rockers13/GTA/UML Class.png

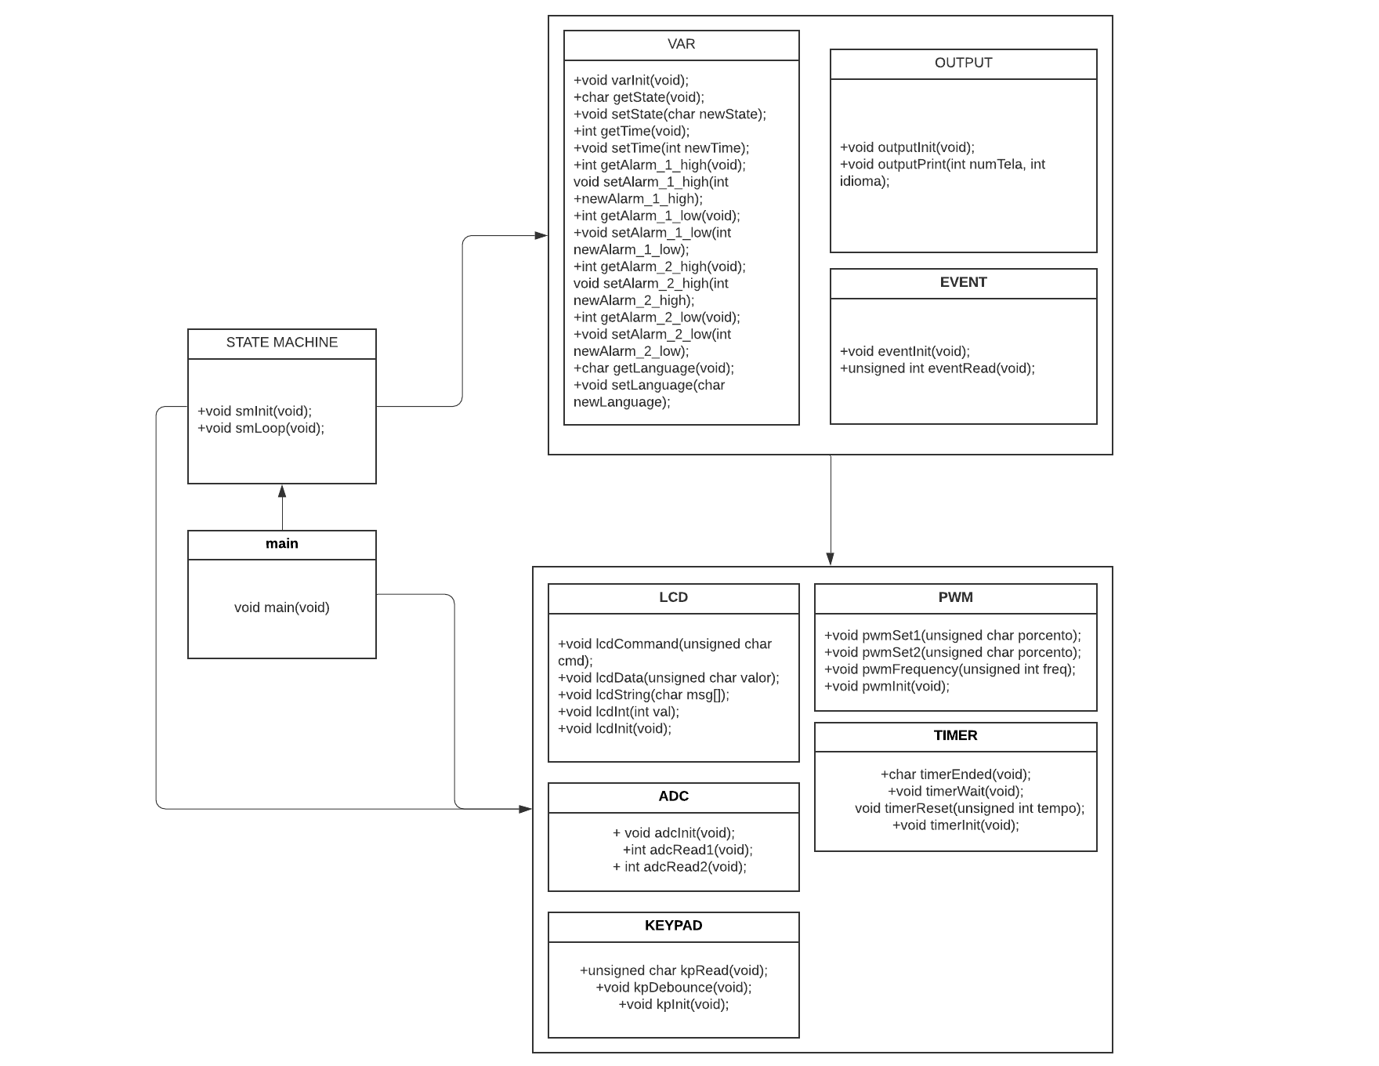
UML Class.png
