rockers13/GTA/Projeto GTA.xlsx

Referencia(s) | Valor | Footprint | Datasheet | Digi-Key Part Number
C1 | 100nF | Capacitor_SMD:C_0805_2012Metric | https://www.we-online.de/katalog/datasheet/885012207045.pdf | 399-1177-1-ND
C2 | 100nF | Capacitor_SMD:C_0805_2012Metric | https://www.we-online.de/katalog/datasheet/885012207045.pdf | 399-1177-1-ND
C3 | 100nF | Capacitor_SMD:C_0805_2012Metric | https://www.we-online.de/katalog/datasheet/885012207045.pdf | 399-1177-1-ND
C4 | 100nF | Capacitor_SMD:C_0805_2012Metric | https://www.we-online.de/katalog/datasheet/885012207045.pdf | 399-1177-1-ND
C5 | 100nF | Capacitor_SMD:C_0805_2012Metric | https://www.we-online.de/katalog/datasheet/885012207045.pdf | 399-1177-1-ND
C6 | 100nF | Capacitor_SMD:C_0805_2012Metric | https://www.we-online.de/katalog/datasheet/885012207045.pdf | 399-1177-1-ND
C7 | 100nF | Capacitor_SMD:C_0805_2012Metric | https://www.we-online.de/katalog/datasheet/885012207045.pdf | 399-1177-1-ND
C8 | 100nF | Capacitor_SMD:C_0805_2012Metric | https://www.we-online.de/katalog/datasheet/885012207045.pdf | 399-1177-1-ND
C9 | 100nF | Capacitor_SMD:C_0805_2012Metric | https://www.we-online.de/katalog/datasheet/885012207045.pdf | 399-1177-1-ND
C10 | 100nF | Capacitor_SMD:C_0805_2012Metric | https://www.we-online.de/katalog/datasheet/885012207045.pdf | 399-1177-1-ND
C11 | 10uF | Capacitor_SMD:C_0805_2012Metric | https://www.we-online.de/katalog/datasheet/885012207045.pdf | 399-4925-1-ND
C12 | 220nF | Capacitor_SMD:C_0805_2012Metric | https://www.we-online.de/katalog/datasheet/885012207045.pdf | 311-1432-1-ND
CP1 | 10uF | Capacitor_Tantalum_SMD:CP_EIA-3216-10_Kemet-I | http://datasheets.avx.com/F93.pdf | 478-8235-1-ND
CP2 | 10uF | Capacitor_Tantalum_SMD:CP_EIA-3216-10_Kemet-I | http://datasheets.avx.com/F93.pdf | 478-8235-1-ND
D1 | 1N5819 | Diode_SMD:D_SOD-123 | http://www.vishay.com/docs/88525/1n5817.pdf | 1N5819HWDICT-ND
D0 | LED | LED_SMD:LED_1206_3216Metric | https://optoelectronics.liteon.com/upload/download/DS-22-98-0004/LTST-C150GKT.pdf | 160-1169-1-ND
D2 | LED | LED_SMD:LED_1206_3216Metric | https://optoelectronics.liteon.com/upload/download/DS-22-98-0004/LTST-C150GKT.pdf | 160-1169-1-ND
D3 | LED | LED_SMD:LED_1206_3216Metric | https://optoelectronics.liteon.com/upload/download/DS-22-98-0004/LTST-C150GKT.pdf | 160-1169-1-ND
D4 | LED | LED_SMD:LED_1206_3216Metric | https://optoelectronics.liteon.com/upload/download/DS-22-98-0004/LTST-C150GKT.pdf | 160-1169-1-ND
D5 | LED | LED_SMD:LED_1206_3216Metric | https://optoelectronics.liteon.com/upload/download/DS-22-98-0004/LTST-C150GKT.pdf | 160-1169-1-ND
IC1 | Micro | Package_QFP:TQFP-48-1EP_7x7mm_P0.5mm_EP3.5x3.5mm | http://ww1.microchip.com/downloads/en/DeviceDoc/60001387c.pdf | PIC32MM0064GPM048-I/PT-ND
J1 | Barrel Jack 4 | Connector_BarrelJack:BarrelJack_Horizontal | https://www.cuidevices.com/product/resource/pj-002a.pdf | CP-002A-ND
J2 | ANALOG IN | TerminalBlock:TerminalBlock_bornier-2_P5.08mm | https://www.on-shore.com/wp-content/uploads/OSTTAXX4163.pdf | ED2580-ND
J3 | ANALOG OUT | TerminalBlock:TerminalBlock_bornier-2_P5.08mm | https://www.on-shore.com/wp-content/uploads/OSTTAXX4163.pdf | ED2580-ND
J4 | PWM | Connector_PinSocket_2.54mm:PinSocket_1x04_P2.54mm_Vertical | https://media.digikey.com/pdf/Data%20Sheets/Sullins%20PDFs/Female_Headers.100_DS.pdf | S7008-ND
J5 | DIGITAL | Connector_PinSocket_2.54mm:PinSocket_1x08_P2.54mm_Vertical | https://media.digikey.com/pdf/Data%20Sheets/Sullins%20PDFs/Female_Headers.100_DS.pdf | S7008-ND
J6 | SPI | Connector_PinHeader_2.54mm:PinHeader_1x02_P2.54mm_Vertical | https://media.digikey.com/pdf/Data%20Sheets/Sullins%20PDFs/Female_Headers.100_DS.pdf | S7008-ND
J7 | TX/RX | Connector_PinHeader_2.54mm:PinHeader_1x02_P2.54mm_Vertical | https://media.digikey.com/pdf/Data%20Sheets/Sullins%20PDFs/Female_Headers.100_DS.pdf | S7008-ND
J8 | ICSP | Connector_PinSocket_2.54mm:PinSocket_1x06_P2.54mm_Vertical | https://media.digikey.com/pdf/Data%20Sheets/Sullins%20PDFs/Female_Headers.100_DS.pdf | S7008-ND
J9 | LCD | Connector_PinSocket_2.54mm:PinSocket_1x16_P2.54mm_Vertical | https://media.digikey.com/pdf/Data%20Sheets/Sullins%20PDFs/Female_Headers.100_DS.pdf | S7008-ND
J10 | Alimentação | Connector_PinSocket_2.54mm:PinSocket_2x04_P2.54mm_Vertical | https://media.digikey.com/pdf/Data%20Sheets/Sullins%20PDFs/Female_Headers.100_DS.pdf | S7008-ND
J11 | USB | Connector_USB:USB_B_OST_USB-B1HSxx_Horizontal | https://br.mouser.com/datasheet/2/273/148-259756.pdf | ED90064-ND
Pot1 | 10K | Potentiometer_THT:Potentiometer_Bourns_3296W_Vertical | https://www.bourns.com/docs/Product-Datasheets/3296.pdf | 3296W-1-103RLFCT-ND
Pot2 | 10K | Potentiometer_THT:Potentiometer_Omeg_PC16BU_Vertical | https://www.ttelectronics.com/TTElectronics/media/ProductFiles/Potentiometers/Datasheets/P160.pdf | 987-1308-ND
R1 | 10K | Resistor_SMD:R_0805_2012Metric | https://www.te.com/commerce/DocumentDelivery/DDEController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 | 311-10.0KCRCT-ND
R6 | 10K | Resistor_SMD:R_0805_2012Metric | https://www.te.com/commerce/DocumentDelivery/DDEController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 | 311-10.0KCRCT-ND
R7 | 10K | Resistor_SMD:R_0805_2012Metric | https://www.te.com/commerce/DocumentDelivery/DDEController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 | 311-10.0KCRCT-ND
R0 | 56R | Resistor_SMD:R_0805_2012Metric | https://www.te.com/commerce/DocumentDelivery/DDEController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 | RHM56.0AECT-ND
R2 | 56R | Resistor_SMD:R_0805_2012Metric | https://www.te.com/commerce/DocumentDelivery/DDEController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 | RHM56.0AECT-ND
R3 | 56R | Resistor_SMD:R_0805_2012Metric | https://www.te.com/commerce/DocumentDelivery/DDEController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 | RHM56.0AECT-ND
R4 | 56R | Resistor_SMD:R_0805_2012Metric | https://www.te.com/commerce/DocumentDelivery/DDEController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 | RHM56.0AECT-ND
R5 | 56R | Resistor_SMD:R_0805_2012Metric | https://www.te.com/commerce/DocumentDelivery/DDEController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 | RHM56.0AECT-ND
R8 | 9K1 | Resistor_SMD:R_0805_2012Metric | https://www.te.com/commerce/DocumentDelivery/DDEController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 | RR12P9.1KDCT-ND
R9 | 4K7 | Resistor_SMD:R_0805_2012Metric | https://www.te.com/commerce/DocumentDelivery/DDEController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 | 311-4.70KCRCT-ND
R10 | 10k | Resistor_SMD:R_0805_2012Metric | https://www.te.com/commerce/DocumentDelivery/DDEController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 | 311-1.0KARCT-ND
R11 | 10k | Resistor_SMD:R_0805_2012Metric | https://www.te.com/commerce/DocumentDelivery/DDEController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 | 311-1.0KARCT-ND
R12 | 1K | Resistor_SMD:R_0805_2012Metric | https://www.te.com/commerce/DocumentDelivery/DDEController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 | 311-1.0KARCT-ND
R13 | 1K | Resistor_SMD:R_0805_2012Metric | https://www.te.com/commerce/DocumentDelivery/DDEController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 | 311-1.0KARCT-ND
R14 | 1K | Resistor_SMD:R_0805_2012Metric | https://www.te.com/commerce/DocumentDelivery/DDEController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 | 311-1.0KARCT-ND
R15 | 1K | Resistor_SMD:R_0805_2012Metric | https://www.te.com/commerce/DocumentDelivery/DDEController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 | 311-1.0KARCT-ND
R16 | 1K | Resistor_SMD:R_0805_2012Metric | https://www.te.com/commerce/DocumentDelivery/DDEController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 | 311-1.0KARCT-ND
R17 | 1K | Resistor_SMD:R_0805_2012Metric | https://www.te.com/commerce/DocumentDelivery/DDEController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 | 311-1.0KARCT-ND
R18 | 1K | Resistor_SMD:R_0805_2012Metric | https://www.te.com/commerce/DocumentDelivery/DDEController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 | 311-1.0KARCT-ND
R19 | 1K | Resistor_SMD:R_0805_2012Metric | https://www.te.com/commerce/DocumentDelivery/DDEController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 | 311-1.0KARCT-ND
R20 | 1K | Resistor_SMD:R_0805_2012Metric | https://www.te.com/commerce/DocumentDelivery/DDEController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 | 311-1.0KARCT-ND
R21 | 1K | Resistor_SMD:R_0805_2012Metric | https://www.te.com/commerce/DocumentDelivery/DDEController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 | 311-1.0KARCT-ND
RST1 | 6K8 | Resistor_SMD:R_0805_2012Metric | https://www.te.com/commerce/DocumentDelivery/DDEController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 | A126384CT-ND
SW0 | RESET | Button_Switch_THT:SW_TH_Tactile_Omron | https://www.te.com/commerce/DocumentDelivery/DDEController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 | 450-1650-ND
SW1 | SW Push | Button_Switch_THT:SW_TH_Tactile_Omron | https://www.te.com/commerce/DocumentDelivery/DDEController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 | 450-1650-ND
SW2 | SW Push | Button_Switch_THT:SW_TH_Tactile_Omron | https://www.te.com/commerce/DocumentDelivery/DDEController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 | 450-1650-ND
SW3 | SW Push | Button_Switch_THT:SW_TH_Tactile_Omron | https://www.te.com/commerce/DocumentDelivery/DDEController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 | 450-1650-ND
SW4 | SW Push | Button_Switch_THT:SW_TH_Tactile_Omron | https://www.te.com/commerce/DocumentDelivery/DDEController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 | 450-1650-ND
SW5 | SW Push | Button_Switch_THT:SW_TH_Tactile_Omron | https://www.te.com/commerce/DocumentDelivery/DDEController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 | 450-1650-ND
U1 | LM358 | Package_SO:SOIC-8_3.9x4.9mm_P1.27mm | https://media.digikey.com/pdf/Data%20Sheets/ON%20Semiconductor%20PDFs/LM358,%20LM258,%20LM2904,%20LM2904A,%20LM2904V.pdf | LM358DGOS-ND
U2 | LM358 | Package_SO:SOIC-8_3.9x4.9mm_P1.27mm | https://media.digikey.com/pdf/Data%20Sheets/ON%20Semiconductor%20PDFs/LM358,%20LM258,%20LM2904,%20LM2904A,%20LM2904V.pdf | LM358DGOS-ND
U3 | LD1117S50TR | Package_TO_SOT_SMD:SOT-223-3_TabPin2 | http://www.st.com/st-web-ui/static/active/en/resource/technical/document/datasheet/CD00000544.pdf | 497-1238-1-ND
U5 | LD1117S33TR | Package_TO_SOT_SMD:SOT-223-3_TabPin2 | http://www.st.com/st-web-ui/static/active/en/resource/technical/document/datasheet/CD00000544.pdf | 497-1241-1-ND
U6 | 24LC512 | Package_SO:SOIC-8_3.9x4.9mm_P1.27mm | http://ww1.microchip.com/downloads/en/DeviceDoc/21754M.pdf | 24LC512-I/SM-ND
USB1 | MCP2200-I-SO | Package_SO:SOIC-20W_7.5x12.8mm_P1.27mm | http://ww1.microchip.com/downloads/en/DeviceDoc/200022228D.pdf | MCP2200-I/SO-ND
USB2 | USB_A | Connector_USB:USB_A | https://br.mouser.com/datasheet/2/273/148-259756.pdf (https://meet.google.com/linkredirect?authuser=0) | ED90064-ND
Y1 | 12MHz | Crystal:Crystal_HC49-4H_Vertical | https://www.ctscorp.com/wp-content/uploads/ATS-ATSSM.pdf | CTX1077-ND
 | Quantidade | Preço
C1 - C11 | 11 | $0.61
C12 | 1 | $0.16
CP1 - CP2 | 2 | $0.88
D1 | 1 | $0.40
D0 - D5 | 4 | $1.24
IC1 | 1 | $1.94
J1 - J10 | 10 | $5.74
J11 | 1 | $1.48
Pot1 | 1 | $4.12
Pot2 | 1 | $0.79
R1, R6, R7 | 3 | $0.30
R0, R2, R3, R4, R5 | 5 | $0.80
R8 | 1 | $0.10
R9 | 1 | $0.10
R10 - R21 | 12 | $0.42
RST1 | 1 | $0.10
SW0 - SW5 | 6 | $0.60
U1, U2 | 2 | $0.92
U3, U5 | 2 | $0.96
U6 | 1 | $1.37
USB1 | 1 | $1.94
USB2 | 1 | $1.48
Y1 | 1 | $0.37
LCD | 1 | $10.64
Total | 71 | $37.46
