rockers13/GTA/Kicad/Projeto GTA.kicad_pcb

## KiCad design Kicad/Projeto GTA.kicad_pcb (2022-08-04)

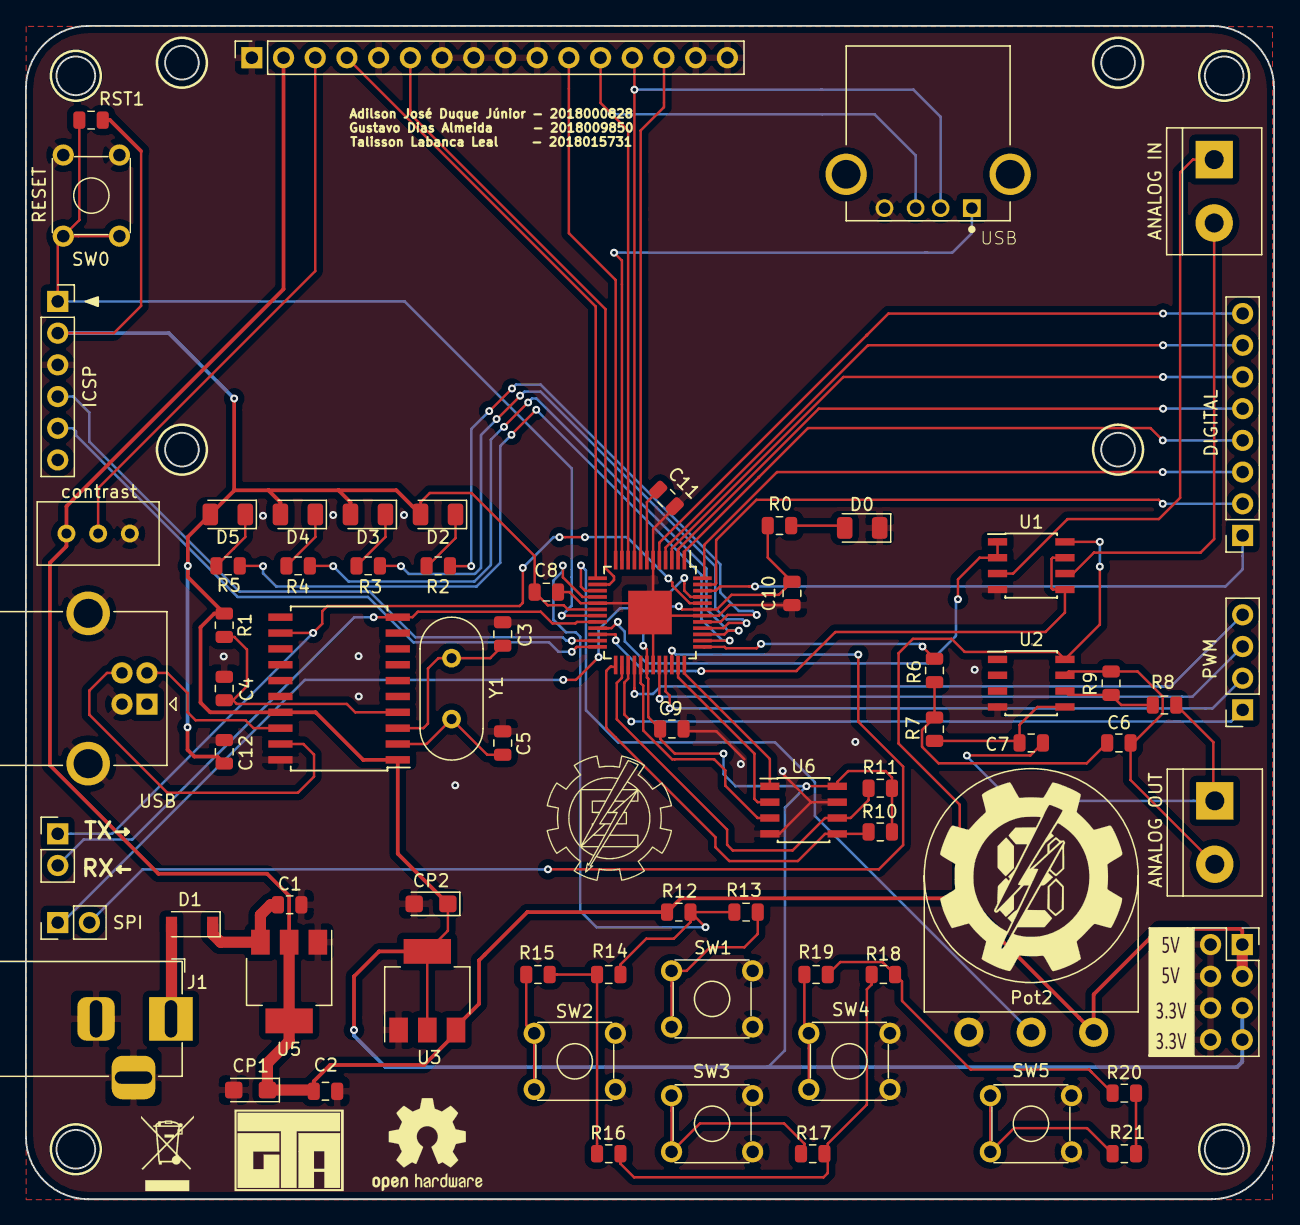
[picture p22: board Projeto GTA.kicad_pcb from above]

Board: 2 copper layers, 100.0 x 94.0 mm, 71 parts (0 on the bottom side), 73 nets.

Parts:
C1, C2, C3, C4, C5, C6, C7, C8, C9, C10: 100nF; C_0805_2012Metric
C11: 10uF; C_0805_2012Metric
C12: 220nF; C_0805_2012Metric
CP1, CP2: 10uF; CP_EIA-3216-10_Kemet-I
D0, D2, D3, D4, D5: LED; LED_1206_3216Metric
D1: 1N5819; D_SOD-123
IC1: Micro; TQFP-48-1EP_7x7mm_P0.5mm_EP3.5x3.5mm
J1: Barrel Jack 4; BarrelJack_Horizontal
J2: ANALOG IN; TerminalBlock_bornier-2_P5.08mm
J3: ANALOG OUT; TerminalBlock_bornier-2_P5.08mm
J4: PWM; PinSocket_1x04_P2.54mm_Vertical
J5: DIGITAL; PinSocket_1x08_P2.54mm_Vertical
J6: SPI; PinHeader_1x02_P2.54mm_Vertical
J7: TX/RX; PinHeader_1x02_P2.54mm_Vertical
J8: ICSP; PinSocket_1x06_P2.54mm_Vertical
J9: LCD; PinSocket_1x16_P2.54mm_Vertical
J10: Alimentação; PinSocket_2x04_P2.54mm_Vertical
J11: USB; USB_B_OST_USB-B1HSxx_Horizontal
Pot1: 10K; Potentiometer_Bourns_3296W_Vertical
Pot2: 10K; Potentiometer_Omeg_PC16BU_Vertical
R0, R2, R3, R4, R5: 56R; R_0805_2012Metric
R1, R6, R7: 10K; R_0805_2012Metric
R8: 9K1; R_0805_2012Metric
R9: 4K7; R_0805_2012Metric
R10, R11: 10k; R_0805_2012Metric
R12, R13, R14, R15, R16, R17, R18, R19, R20, R21: 1K; R_0805_2012Metric
RST1: 6K8; R_0805_2012Metric
SW0: RESET; SW_TH_Tactile_Omron
SW1, SW2, SW3, SW4, SW5: SW Push; SW_TH_Tactile_Omron
U1, U2: LM358; SOIC-8_3.9x4.9mm_P1.27mm
U3: LD1117S50TR; SOT-223-3_TabPin2
U5: LD1117S33TR; SOT-223-3_TabPin2
U6: 24LC512; SOIC-8_3.9x4.9mm_P1.27mm
USB1: MCP2200-I-SO; SOIC-20W_7.5x12.8mm_P1.27mm
USB2: USB; USB_A
Y1: 12MHz; Crystal_HC49-4H_Vertical

Connections:
3V3: C8.1, C9.2, C10.1, C12.2, CP2.1, D2.2, D3.2, D4.2, D5.2, IC1.18, IC1.30, IC1.43, J8.2, J10.5, J10.7, R0.1, R1.1, R10.1, R11.1, RST1.2, U3.2, U6.8, USB1.1, USB1.17
5V: C2.1, CP1.1, J9.2, J10.1, J10.3, Pot1.1, Pot2.1, R12.1, U1.8, U2.8, U3.3, U5.2
/D+: J11.3, USB1.19
/D-: J11.2, USB1.18
AN9: IC1.15, Pot2.2
B4: IC1.12, J9.11
B5: IC1.10, J9.12, USB2.3
B6: IC1.9, J9.13, USB2.2
B7: IC1.8, J9.14
D1: IC1.41, R2.1
D2: IC1.40, R3.1
D3: IC1.39, R4.1
D4: IC1.38, R5.1
E: IC1.14, J9.6
Filtro: IC1.37, R6.2
GND: C1.2, C2.2, C3.2, C4.2, C5.2, C8.2, C9.1, C10.2, C11.1, C12.1, CP1.2, CP2.2, D0.1, IC1.6, IC1.17, IC1.31, IC1.42, IC1.49, J1.2, J1.3, J8.3, J9.1, J9.5, J9.7, J9.8, J9.9, J9.10, J9.15, J9.16, J10.2, J10.4, J10.6, J10.8, J11.4, J11.5, Pot1.3, Pot2.3, SW0.2, SW0.4, SW1.2, SW1.4, SW2.2, SW2.4, SW3.2, SW3.4, SW4.2, SW4.4, SW5.2, SW5.4, U1.4, U2.4, U3.1, U5.1, U6.4, U6.7, USB1.20, USB2.4
IO1: IC1.1, J5.4
IO2: IC1.2, J5.5
IO3: IC1.3, J5.6
IO4: IC1.4, J5.7
IO5: IC1.5, J5.8
IO29: IC1.29, U6.3
IO35: IC1.35, U6.2
IO36: IC1.36, U6.1
IO46: IC1.46, J5.1
IO47: IC1.47, J5.2
IO48: IC1.48, J5.3
MCLR: IC1.19, J8.1, RST1.1, SW0.1, SW0.3
unnamed: C1.1, D1.1, U5.3
unnamed: C3.1, USB1.3, Y1.2
unnamed: C4.1, R1.2, USB1.4
unnamed: C5.1, USB1.2, Y1.1
unnamed: C6.1, R6.1, R7.2
unnamed: C6.2, J3.2, R9.1, U2.7
unnamed: C7.1, R7.1, U2.5
unnamed: C7.2, J3.1, R8.2
unnamed: D0.2, R0.2
unnamed: D1.2, J1.1
unnamed: D2.1, R2.2
unnamed: D3.1, R3.2
unnamed: D4.1, R4.2
unnamed: D5.1, R5.2
unnamed: J2.1, U1.3
unnamed: J2.2, U1.6
unnamed: J9.3, Pot1.2
unnamed: R8.1, R9.2, U2.6
unnamed: R13.2, SW1.1, SW1.3
unnamed: R14.2, R15.1, R16.1
unnamed: R15.2, SW2.1, SW2.3
unnamed: R16.2, R17.1, R18.1
unnamed: R17.2, SW3.1, SW3.3
unnamed: R18.2, R19.1, R20.1
unnamed: R19.2, SW4.1, SW4.3
unnamed: R20.2, R21.1
unnamed: R21.2, SW5.1, SW5.3
PGEC: IC1.24, J8.5
PGED: IC1.23, J8.4
PWM27: IC1.27, J4.1
PWM28: IC1.28, J4.4
PWM32: IC1.32, J4.3
PWM33: IC1.33, J4.2
RA0: IC1.21, U1.1, U1.2
RA1: IC1.22, U1.5, U1.7
RS: IC1.13, J9.4
RX: IC1.20, J7.2, USB1.10
SCL: IC1.26, R11.2, U6.6
SDA: IC1.25, R10.2, U6.5
SPI34: IC1.34, J6.2
SPI45: IC1.45, J6.1
SW: IC1.16, R12.2, R13.1, R14.1
TX: IC1.44, J7.1, USB1.12
VCAP: C11.2, IC1.7
VUSB: IC1.11, USB2.1
